gabor7d2/8bit-computer/README.md

# 8-bit computer

[SerialTransfer](https://github.com/gabor7d2/SerialTransfer) is used for programming the Control Unit and the computer's flash
