gabor7d2/8bit-computer/Code/SN76489/sn76489 notes.txt

111 (7) -> 1120 Hz

f = N  / 32n
1120 = N / 32 * 7
1120 = N / 224
1120*224 = N = 250 kHz

1101 (13) -> 603 Hz
603*(32*13) = 250 kHz

500 kHz
f = 500000 / 32*13 = 1202 Hz

3000*(32*13) = 1,25 MHz
3984*(32*13) = 1,65 MHz

200 - 0100100111
223 - 
200
891 - 
167
398
445
126
398

0010010101
0000101111
0000101000

[7]
88
100
170

[3]
173
199
337

[2]
231 0000101101
267 0000100111
451 0010010111

[wanted]
262
330
392

199 hz
267 hz
