gabor7d2/8bit-computer/Control signals.docx

HLT | TR | MAHI | MALI | ME | MW | | PGO
| | | IRI | INO | SI | DI | DRS
AO | AI | BO | BI | CO | CI | SPO | SPI
PCHO | PCHI | PCLO | PCLI | PCC | FO | FW | FI
ALS0 | ALS1 | ALS2 | ALO | ALW | ALB | ALC
