gabor7d2/8bit-computer/8-bites számítógép prezentáció.pptx

## 8-bites számítógép építése

Tóth Gábor, Szilczer Ármin, Tátos Vencel
konzulens tanár: Olejnik Árpád

## A projekt célja

- Megérteni, hogyan épül fel egy processzor
- Valós, működő szoftvert készíteni, egy új processzor architektúrát létrehozva
- Ezt a tudást átadni az érdeklődőknek
- Színes ledeket villogtatni, mert az királyul néz ki
- Esztétikailag szemgyönyörködtető műalkotást létrehozni

## Processzorok előfordulása

- Számítógép, laptop, tablet, telefon, okosóra …
- Ezek kiegészítői, pl. vezeték nélküli füles, telefontöltő!
- Háztartási gépek
- Manapság szinte mindenhol

## A gépünk JELLEMZŐI

- 32 KB programmemória (a tárhely)
- 8 KB RAM
- 4 db interakciós gomb
- 2x16 karakteres (2 soros) kijelző
- Hanggenerátor 8-bites zenék lejátszására

## inspiráció

- Ben Eater
- James Bates
- Kiss Bálint

## Felépítés röviden

- Modulok

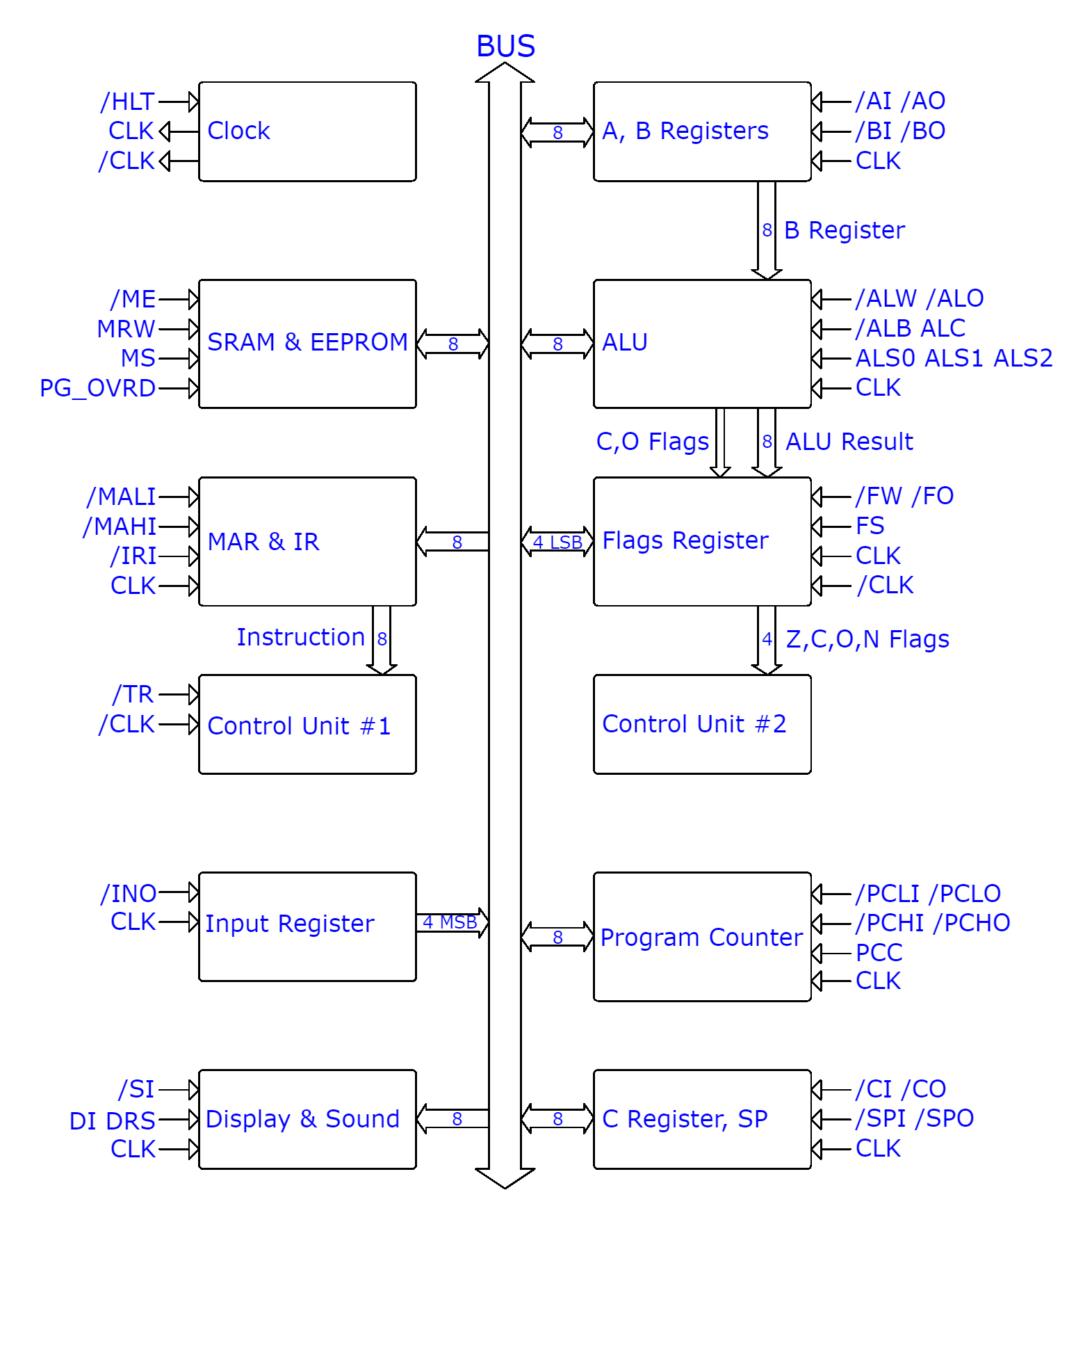
[picture p1: figure]
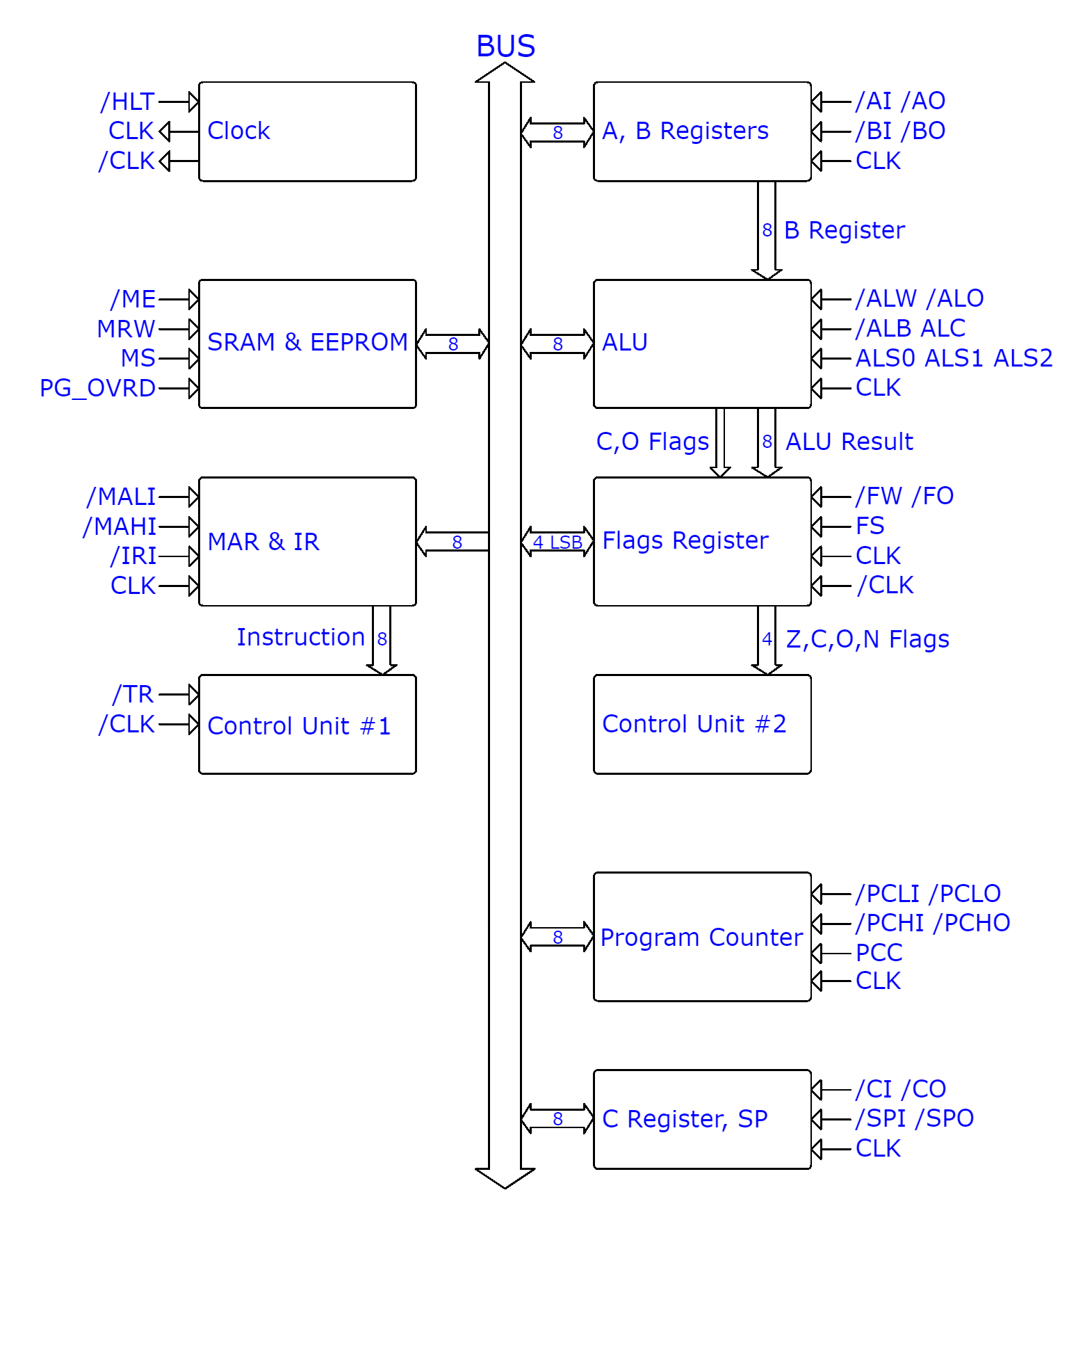
[picture p2: figure]
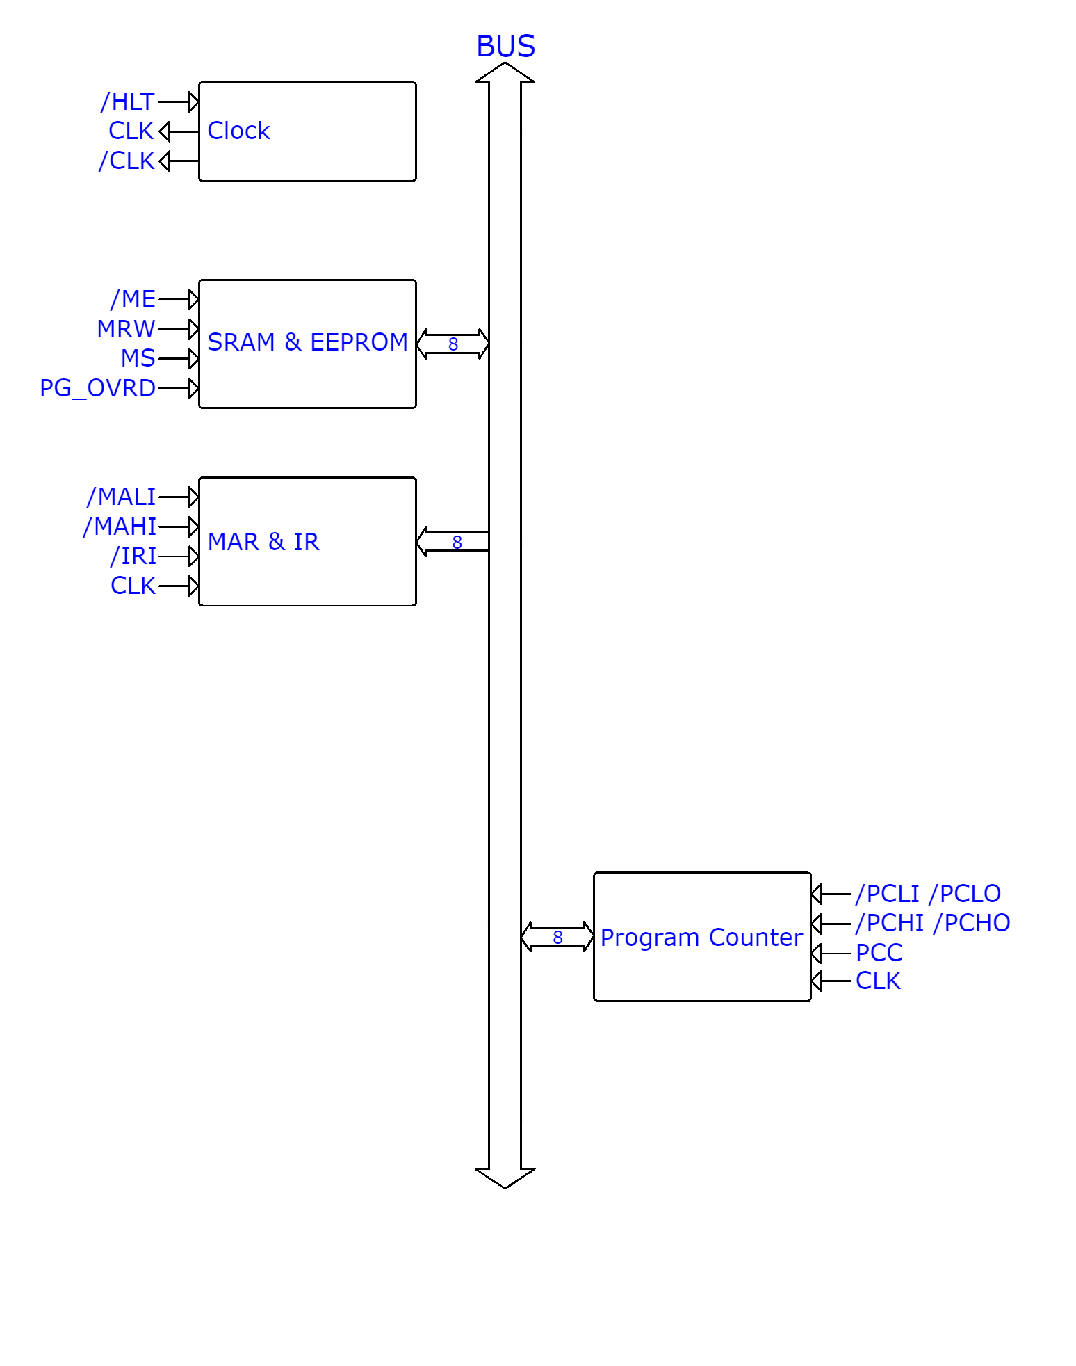
[picture p3: figure]
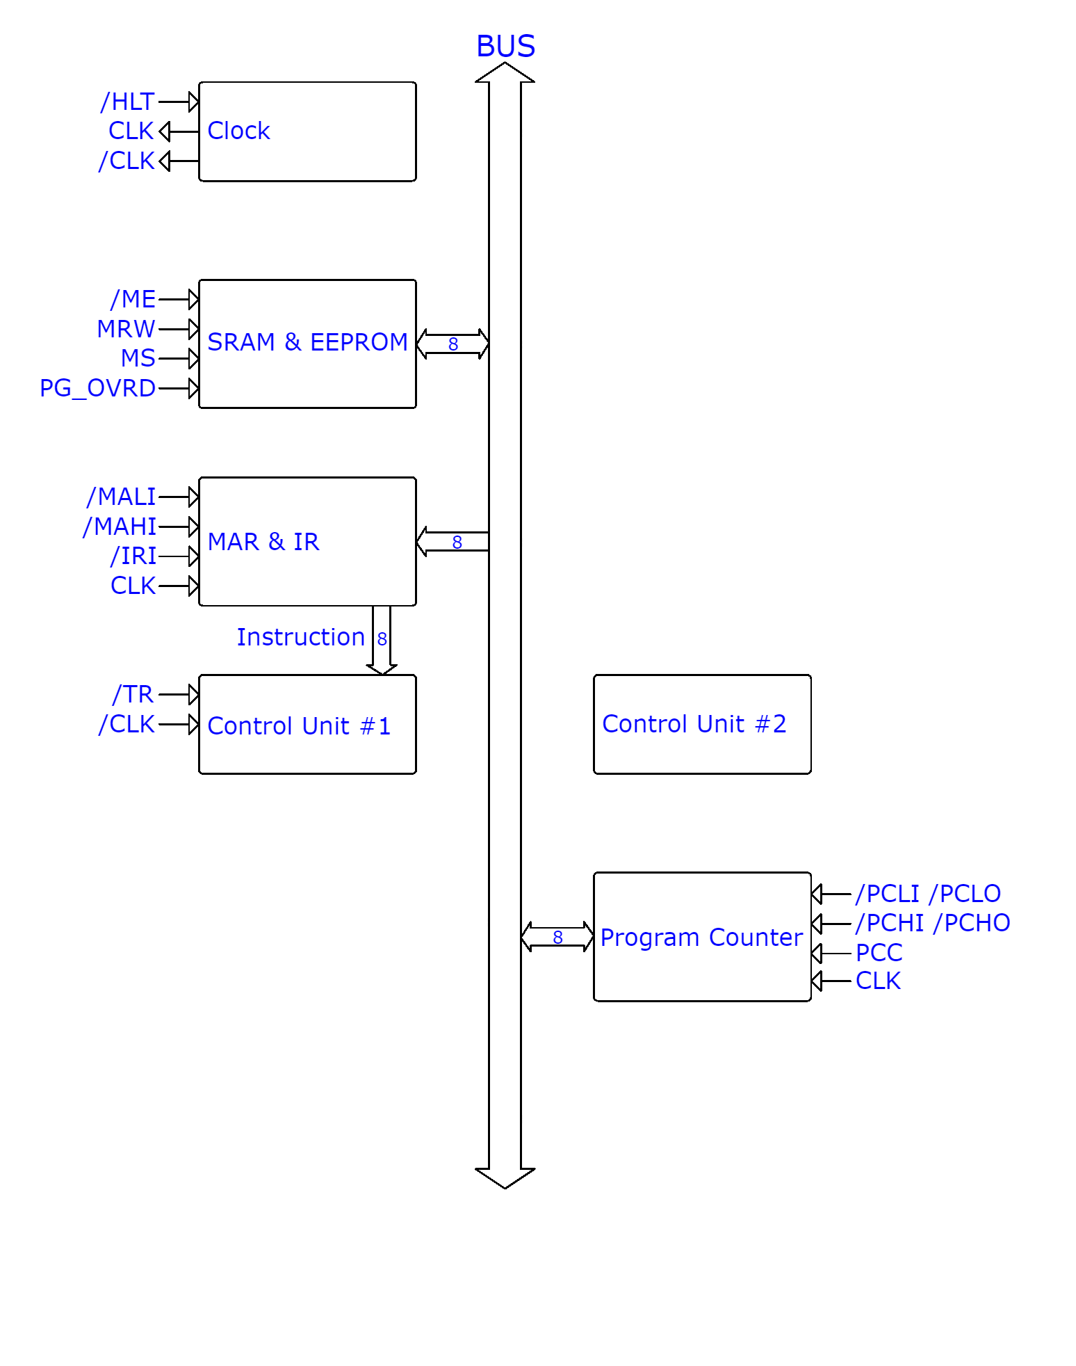
[picture p4: figure]
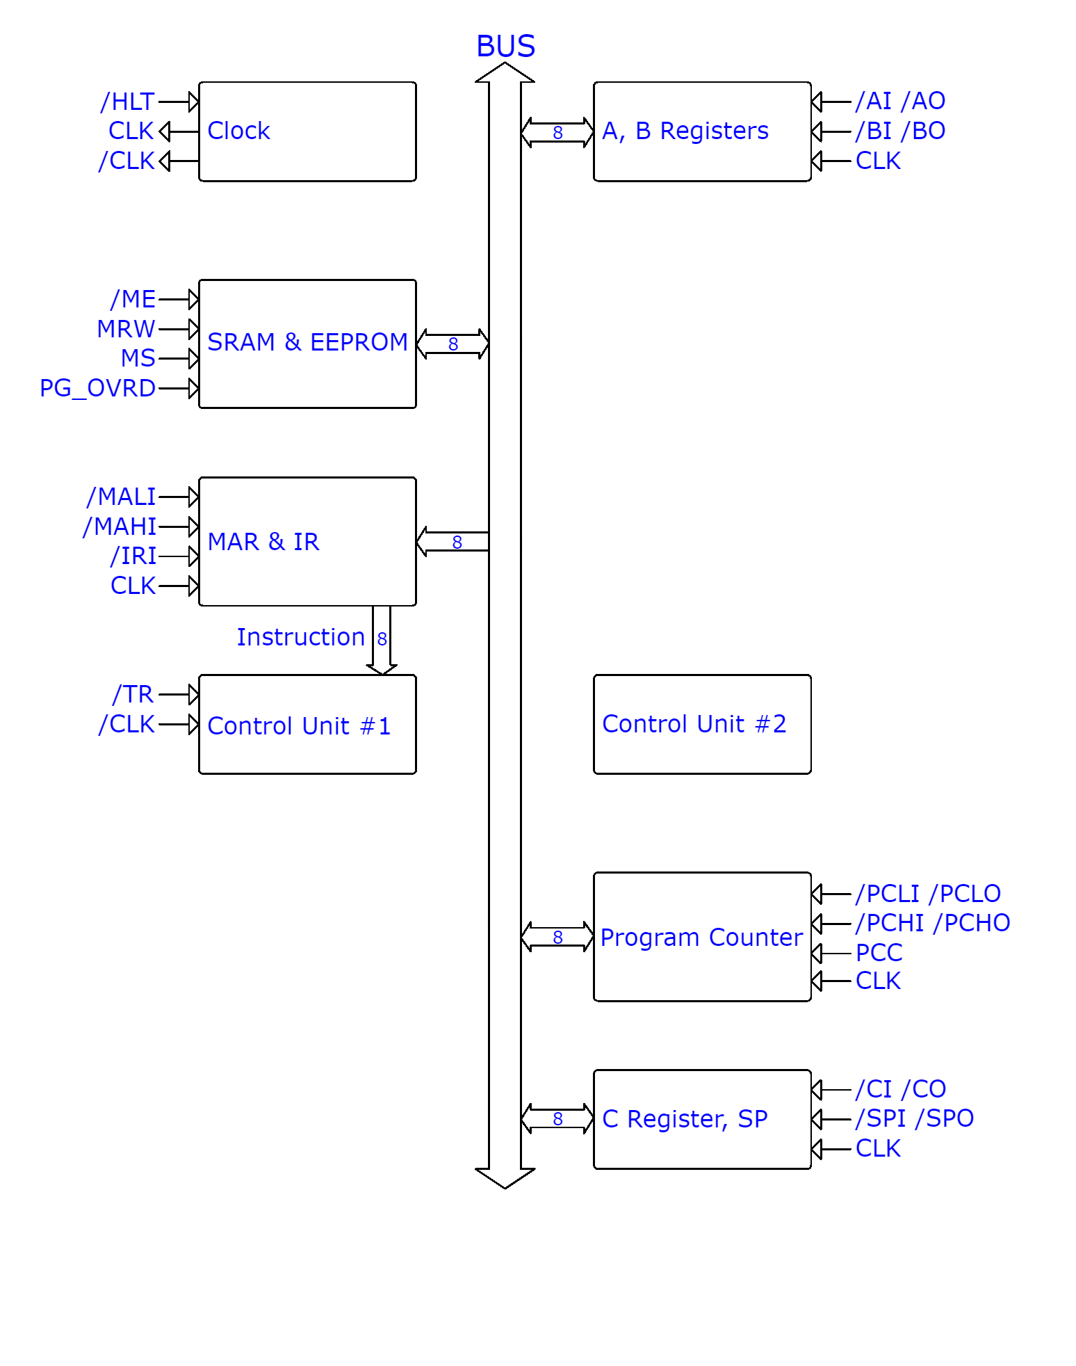
[picture p5: figure]
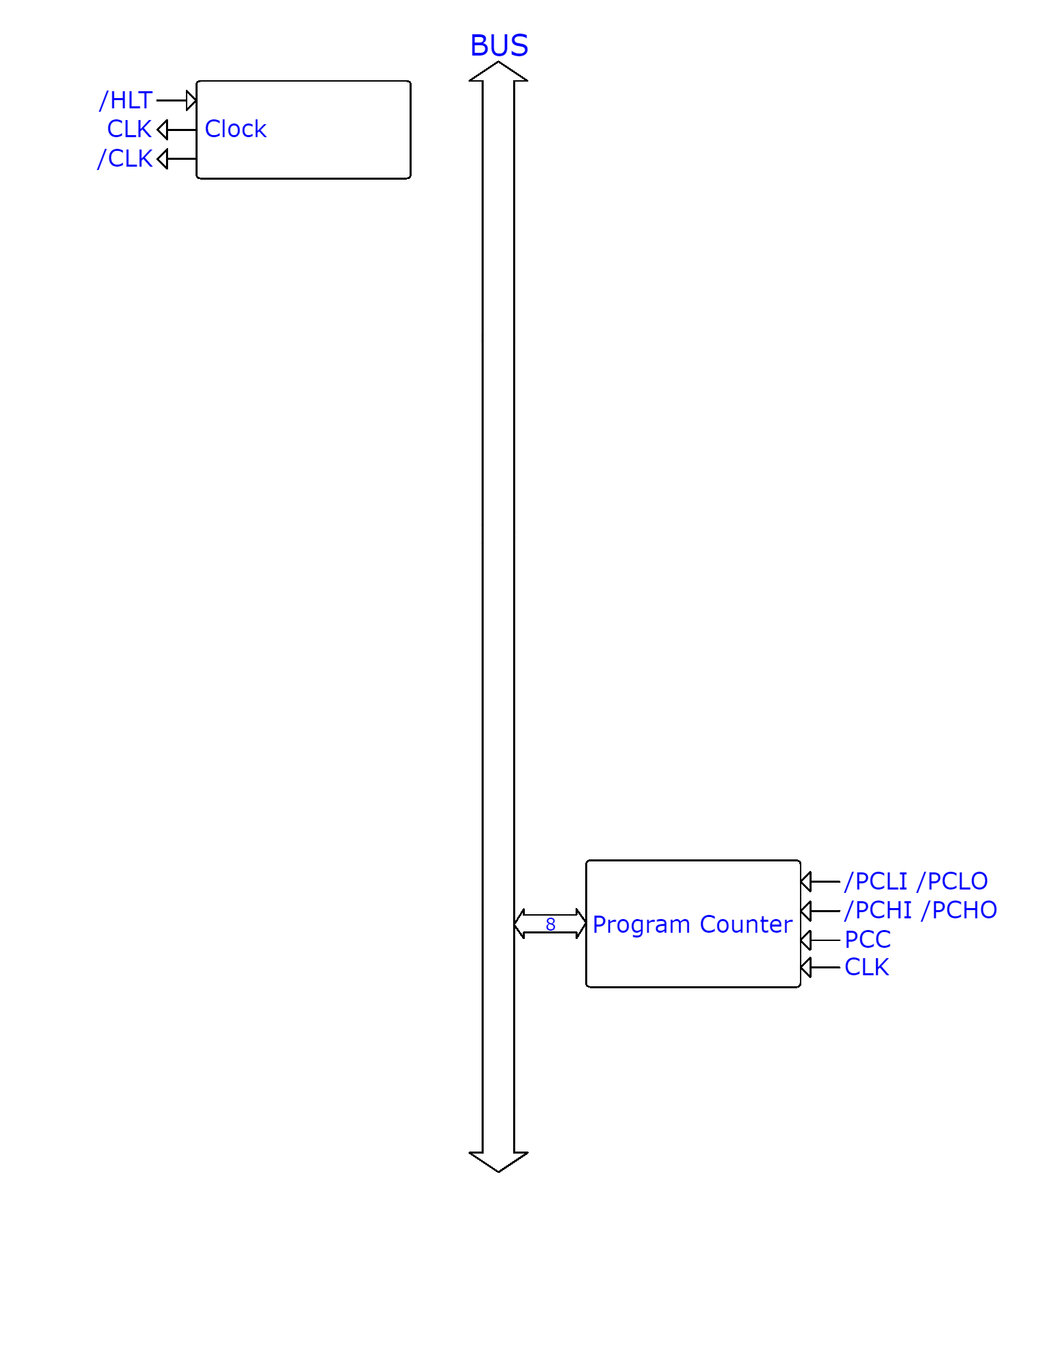
[picture p6: figure]
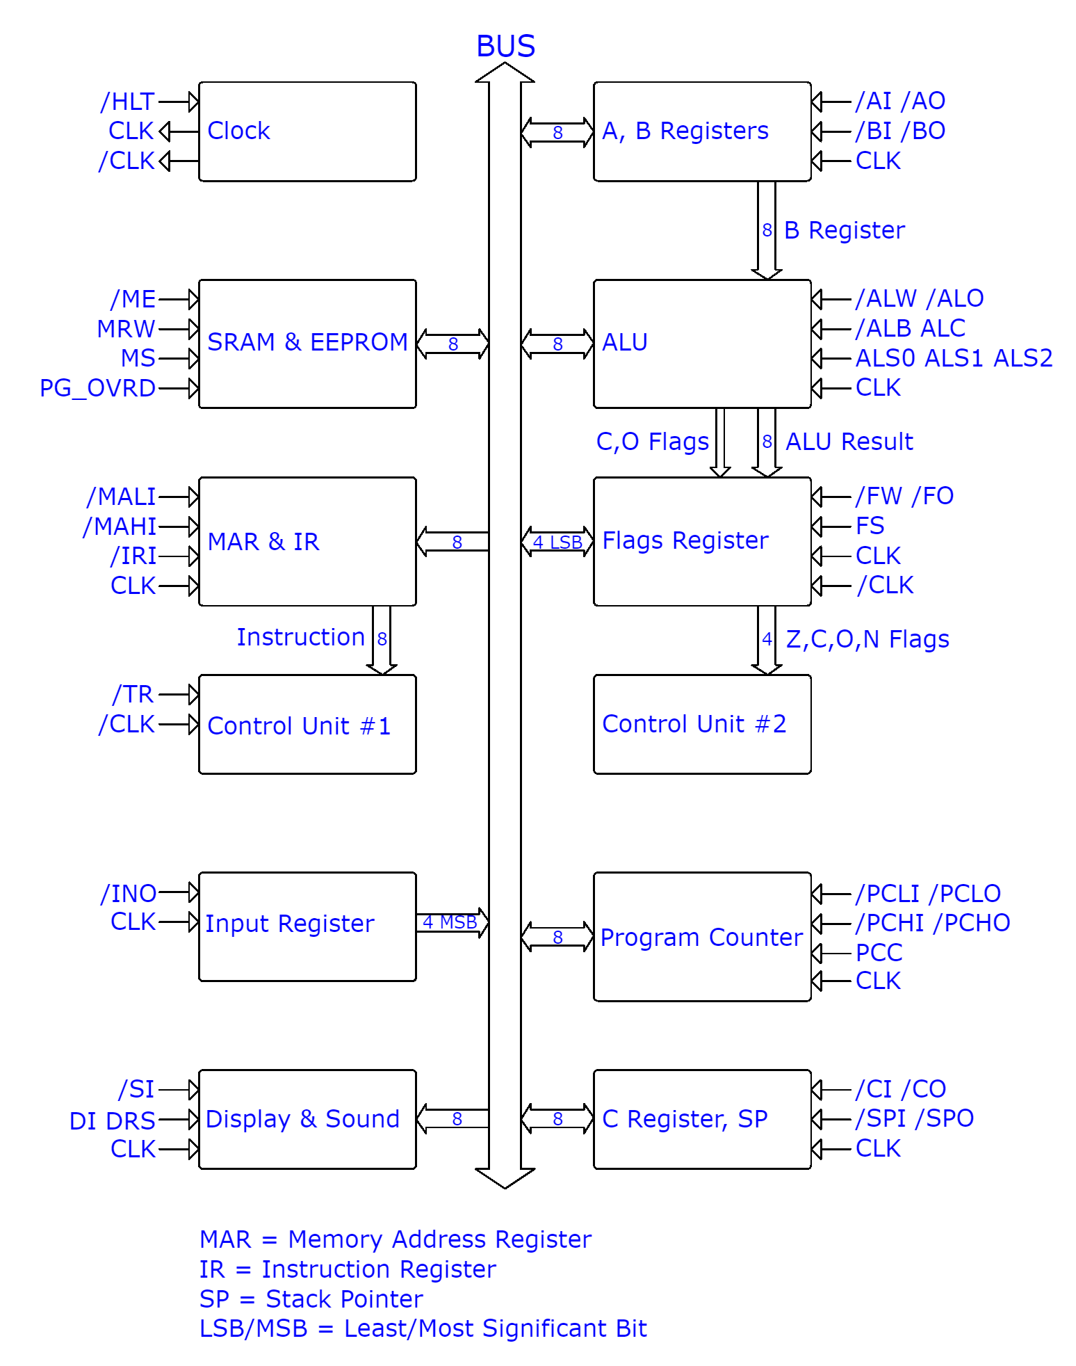
[picture p7: figure]
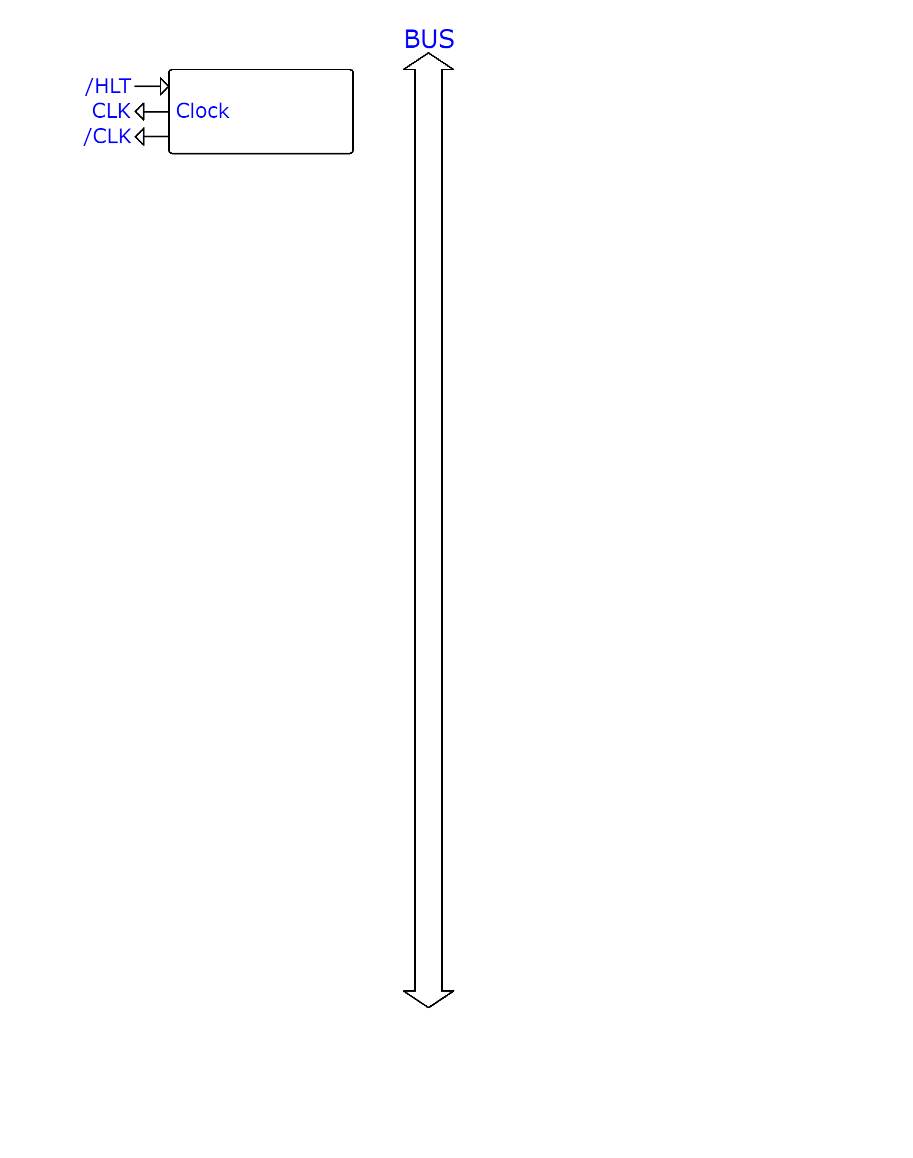
[picture p8: figure]

## Elértük a célt?

Röviden: igen
Hosszabban: …

## További célok

- Fa/műanyag ház készítése
- Kijelző nagyobb méretűvé cserélése
- Több beviteli eszköz, például kontrollerek
- Multiplayer játékok (2-játékos)

## Hasznos linkek

- A projekt Drive mappája: http://tiny.cc/8bitcp
- A projekt tervrajzai: https://easyeda.com/gabor6505/8-bit-computer-v1-0
- Az építés során készült képek Gábor Instagram oldalán: @tothgabor6505

## Köszönjük a figyelmet!

Bátran gyertek a szünetben kipróbálni a gépet!

Kérdések?
