gabor7d2/8bit-computer/images/zene.png

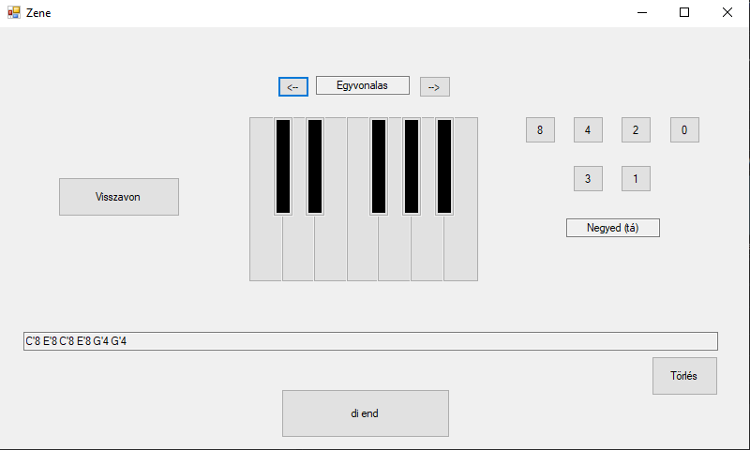
images/zene.png
