gabor7d2/8bit-computer/Schematic/ALU.png

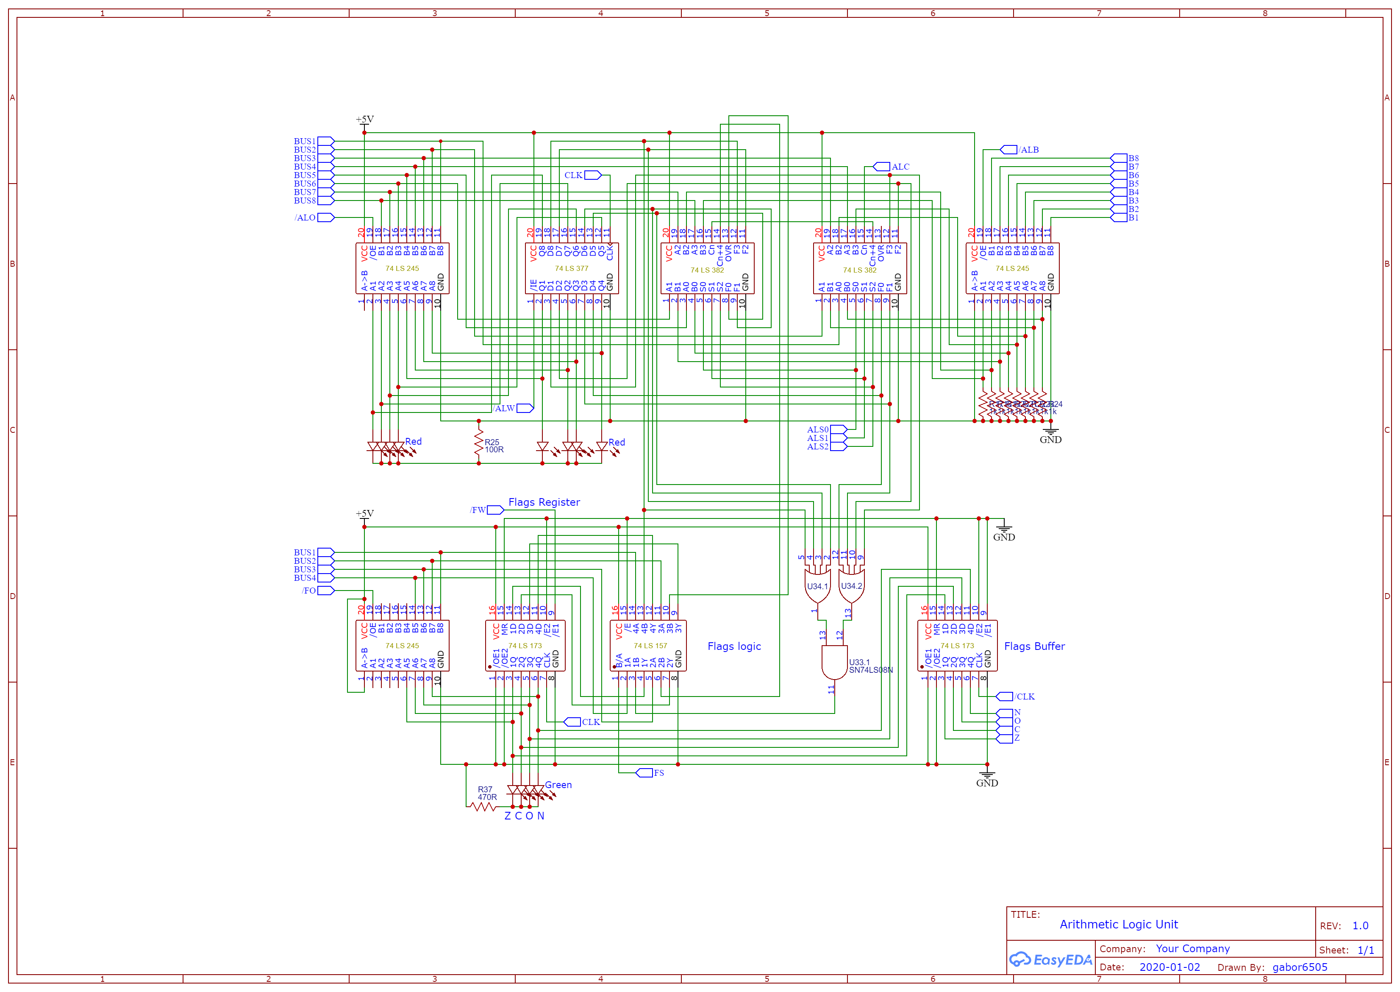
Schematic/ALU.png
