gabor7d2/8bit-computer/Schematic/Clock.png

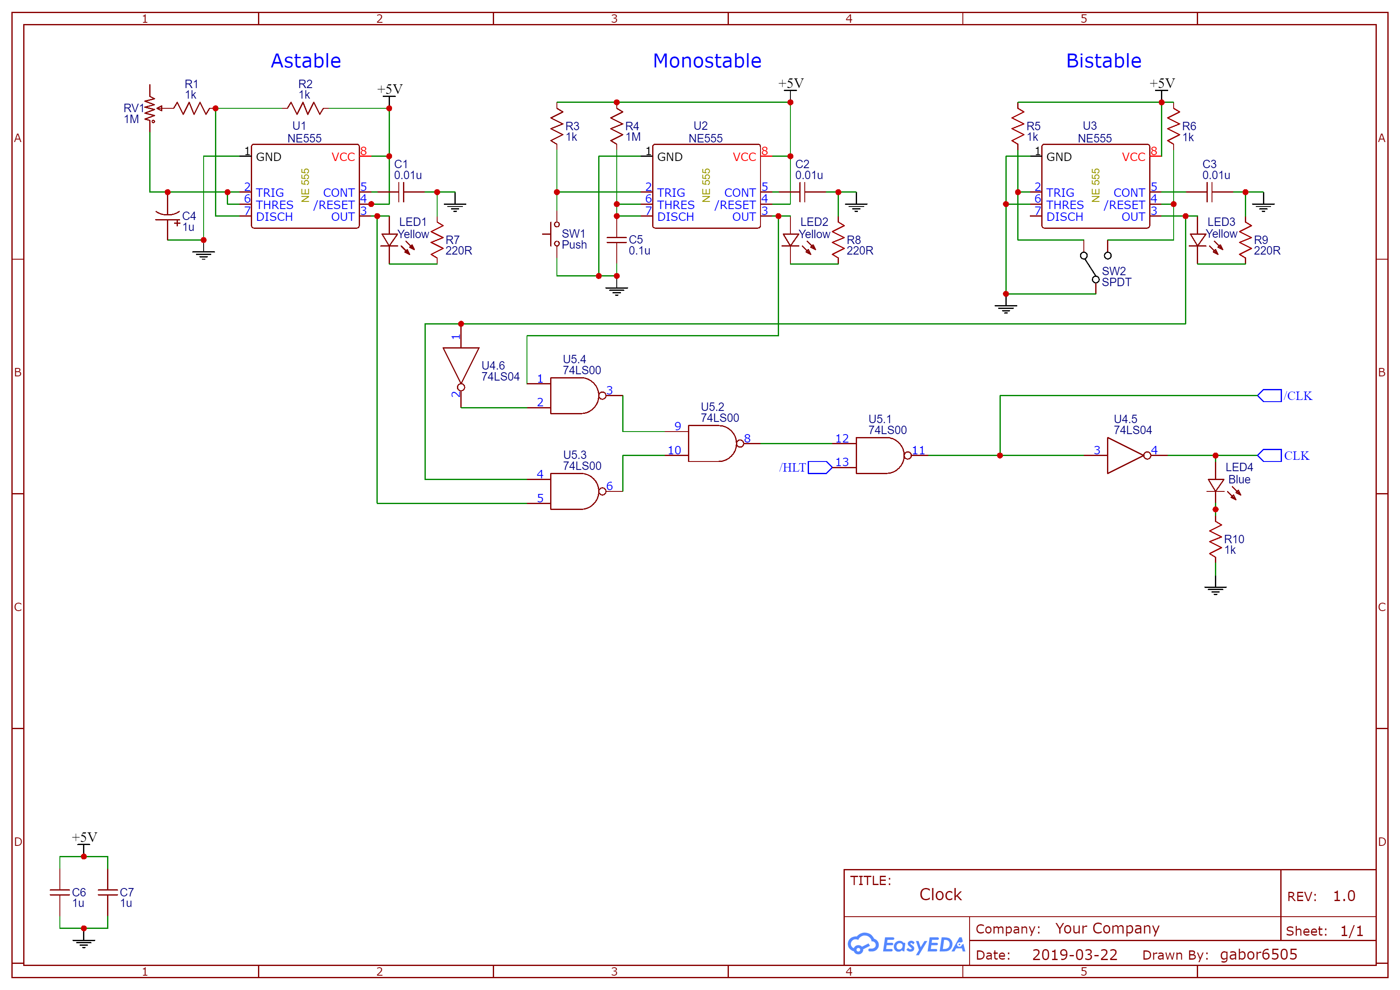
Schematic/Clock.png
