gabor7d2/8bit-computer/Schematic/Control Unit.png

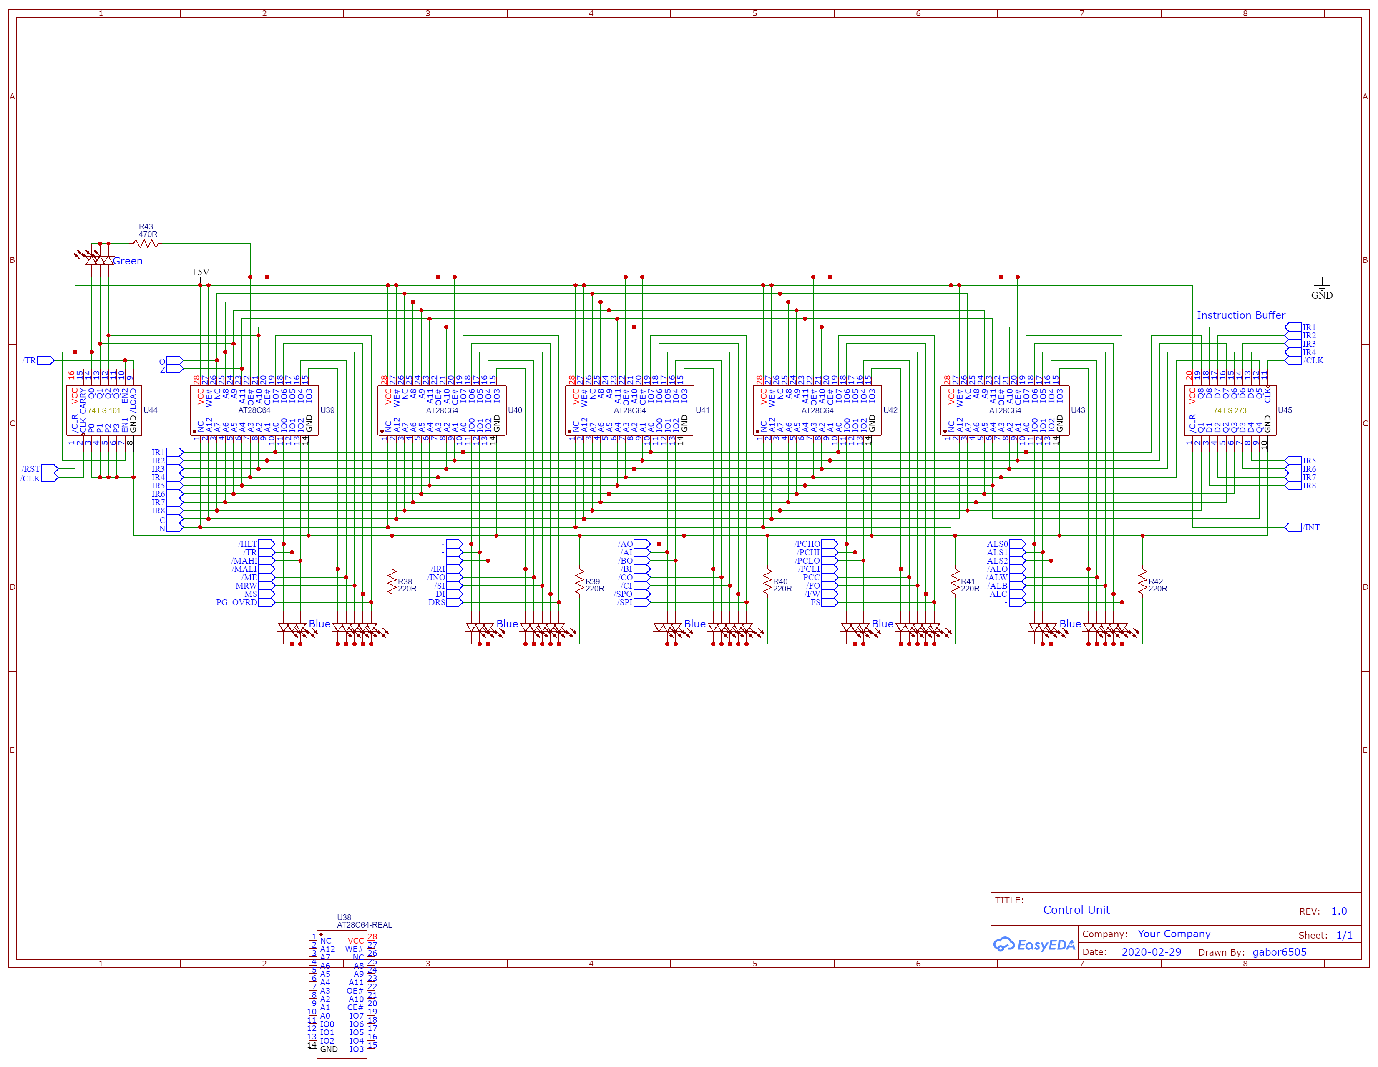
Schematic/Control Unit.png
