gabor7d2/8bit-computer/Schematic/Memory.png

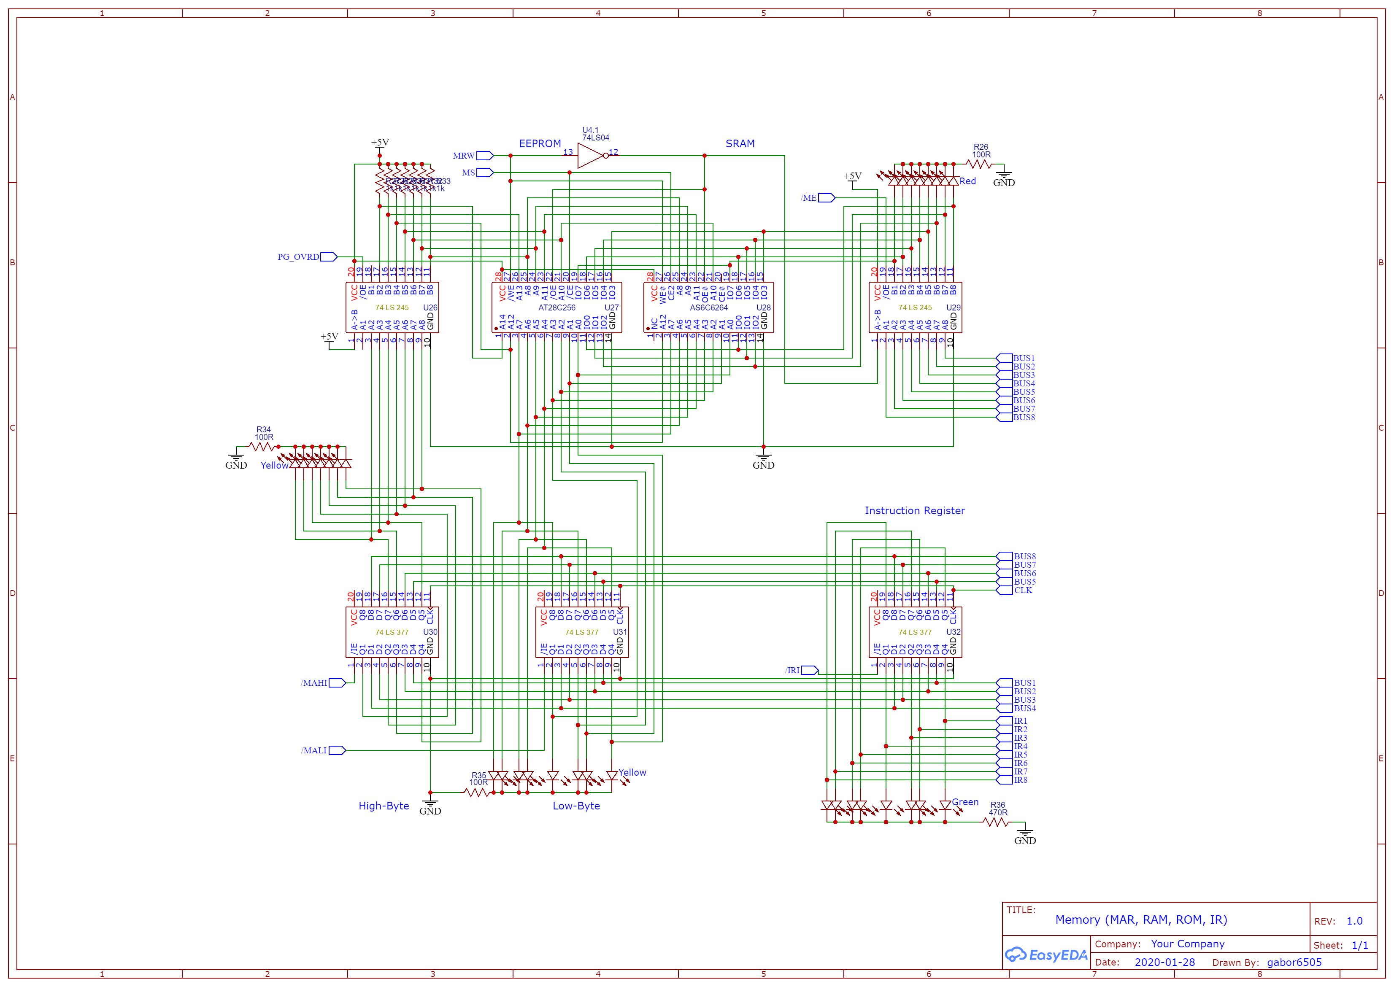
Schematic/Memory.png
