gabor7d2/8bit-computer/Schematic/Modules.png

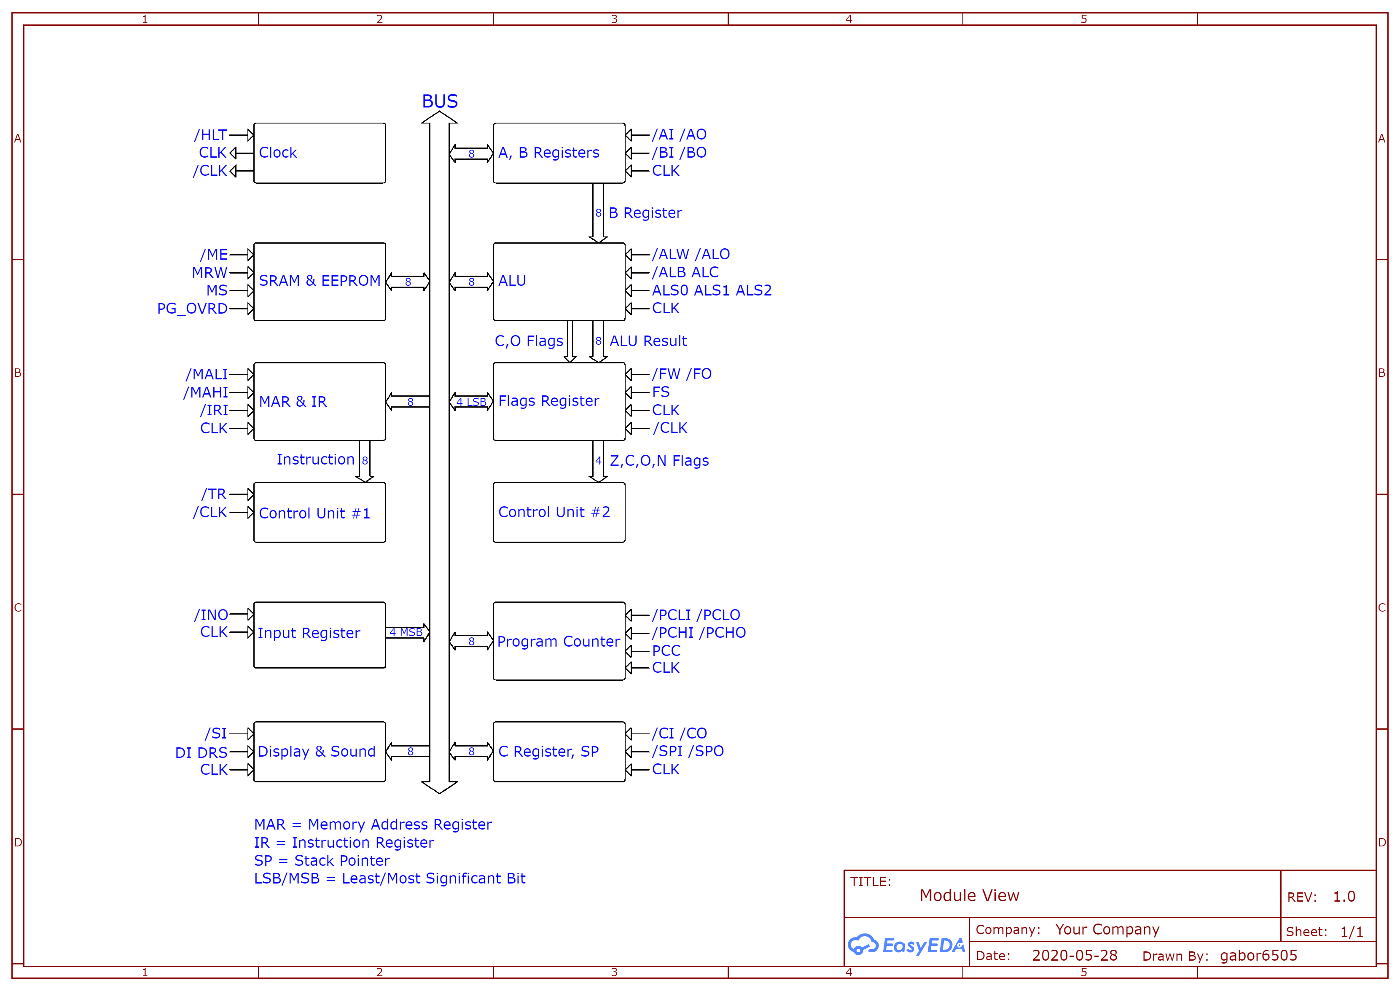
Schematic/Modules.png
