gabor7d2/8bit-computer/Schematic/PC.png

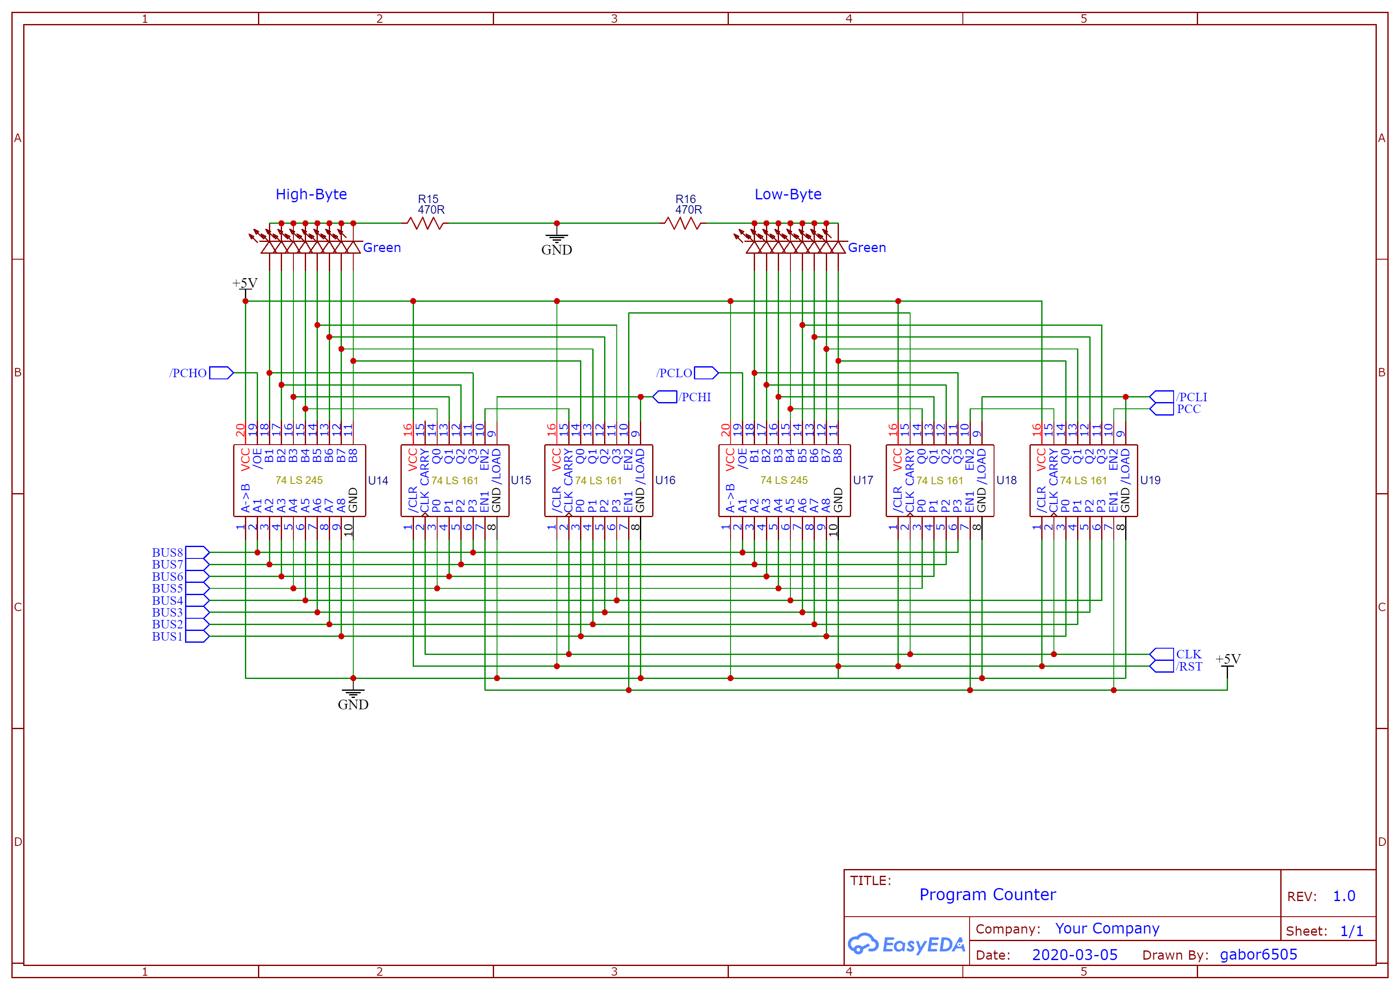
Schematic/PC.png
