gabor7d2/8bit-computer/Schematic/Registers.png

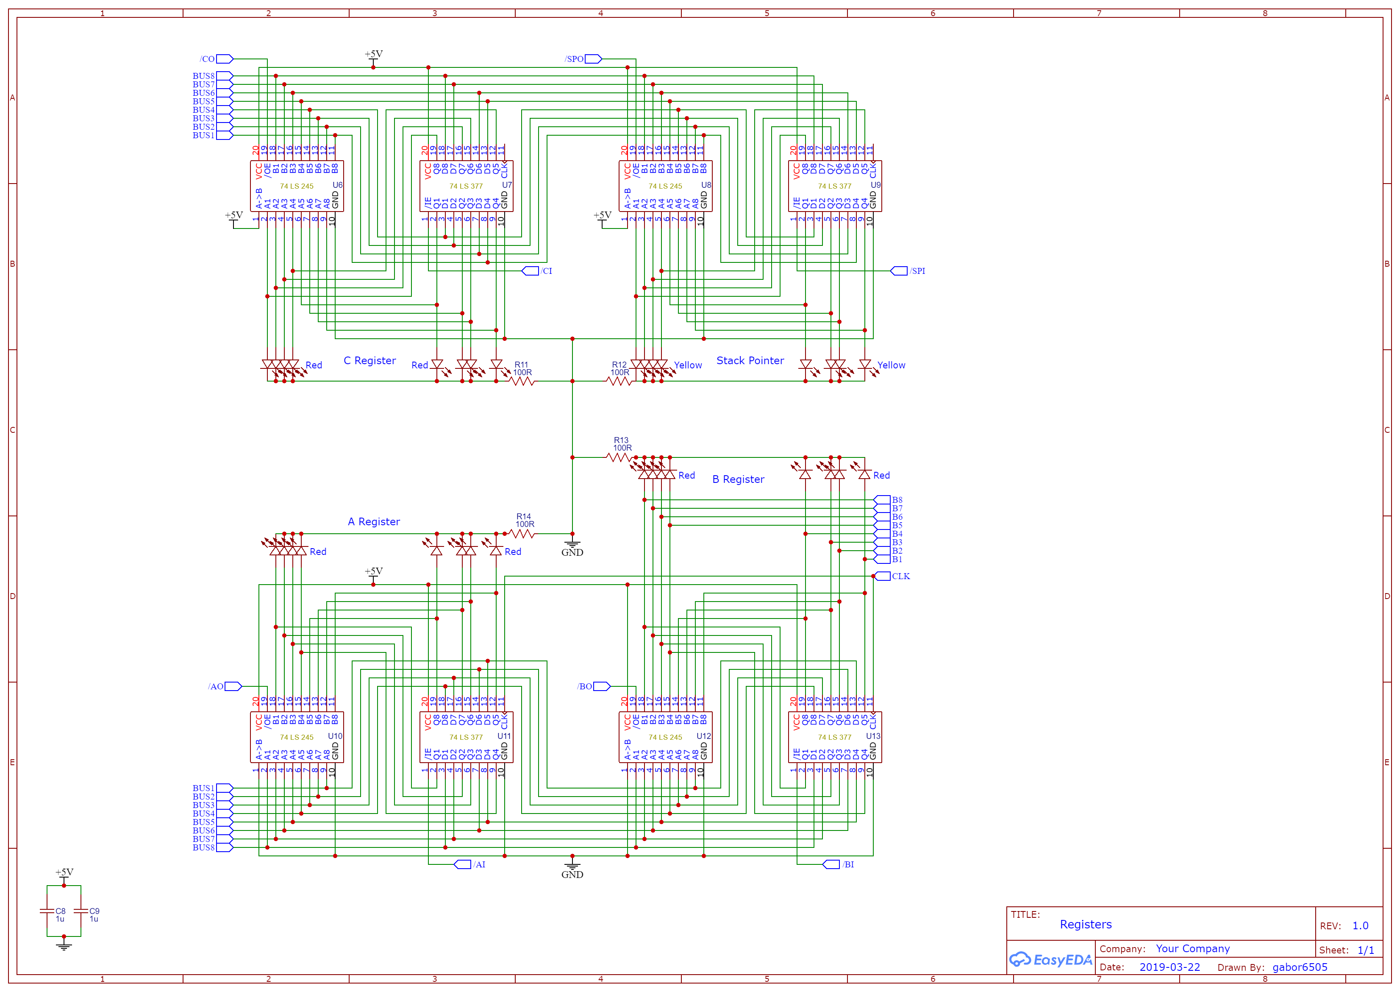
Schematic/Registers.png
