gabor7d2/8bit-computer/images/alu_print.jpg

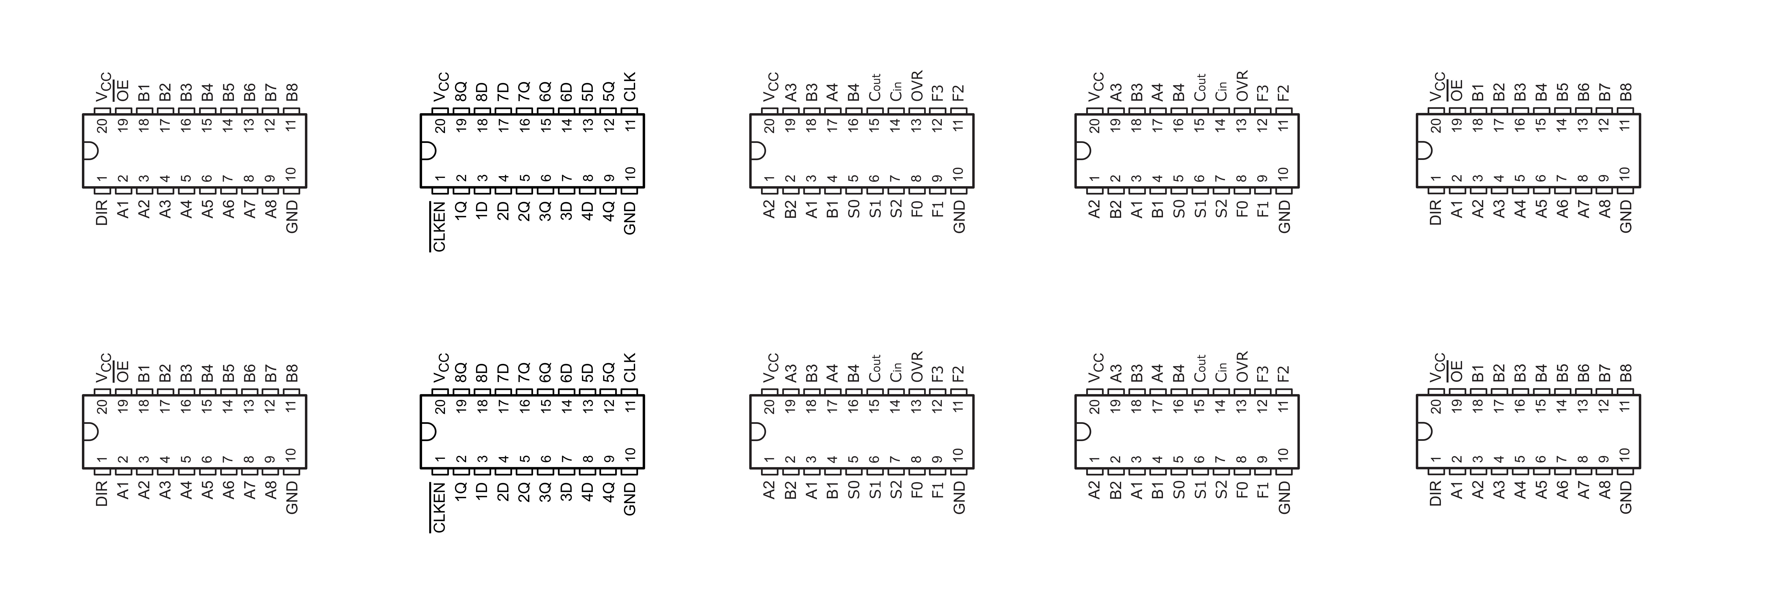
images/alu_print.jpg
